xnotox/CEM3340/3D/cem3340v2_bottom.jpg

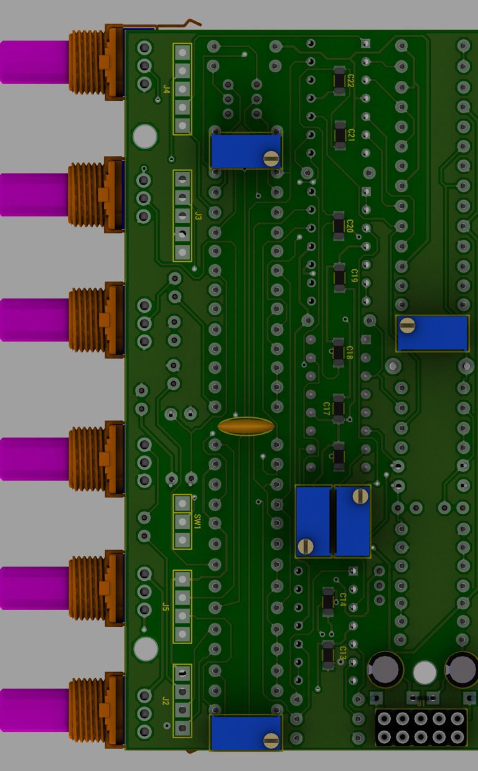
3D/cem3340v2_bottom.jpg
