xnotox/CEM3340/3D/cem3340v2_top.jpg

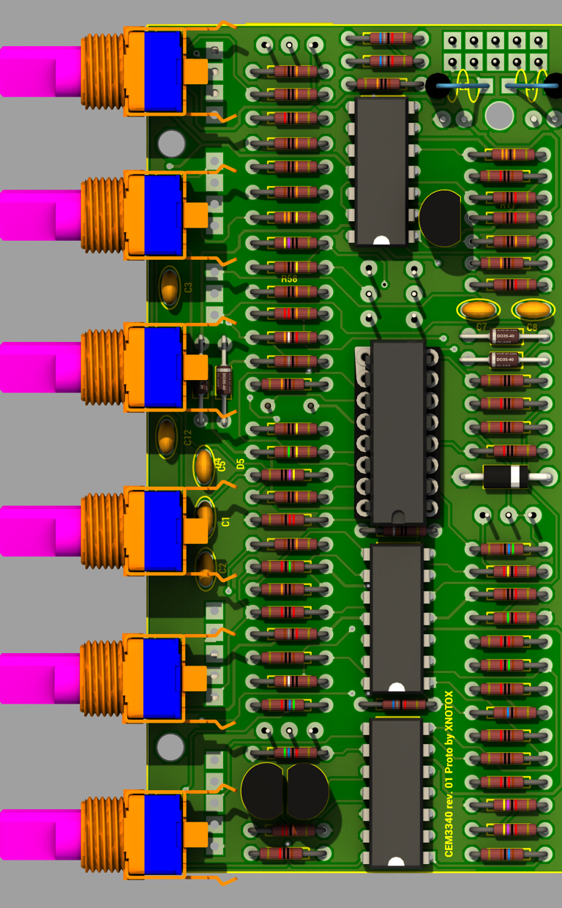
3D/cem3340v2_top.jpg
