xnotox/CEM3340/3D/cem3340v2_perspective.jpg

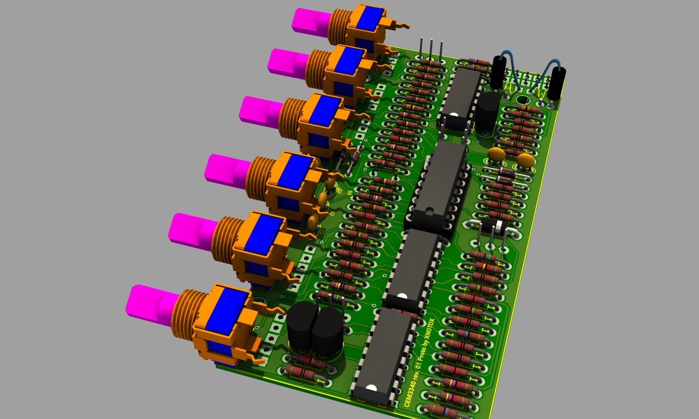
3D/cem3340v2_perspective.jpg
