xnotox/CEM3340/3D/cem3340v3_top.jpg

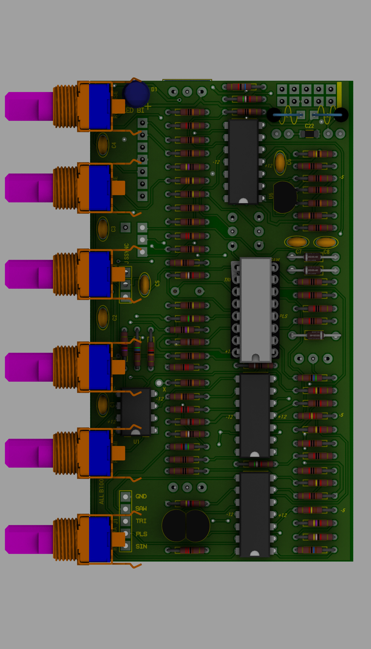
3D/cem3340v3_top.jpg
