xnotox/CEM3340/PANEL/cemop.dxf

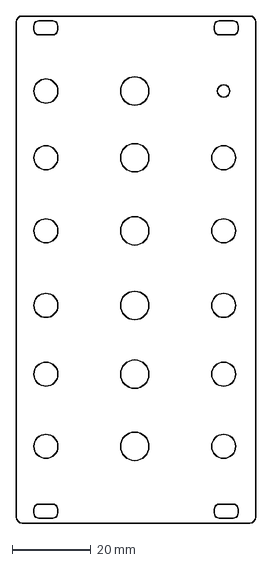
[picture p14: CAD file, 2016-11-08]
PANEL/cemop.dxf
60.6 x 128.4 mm
