xnotox/CEM3340/SCHEMATIC/OpenCEM3340_rev0.3_pulsealt.PDF

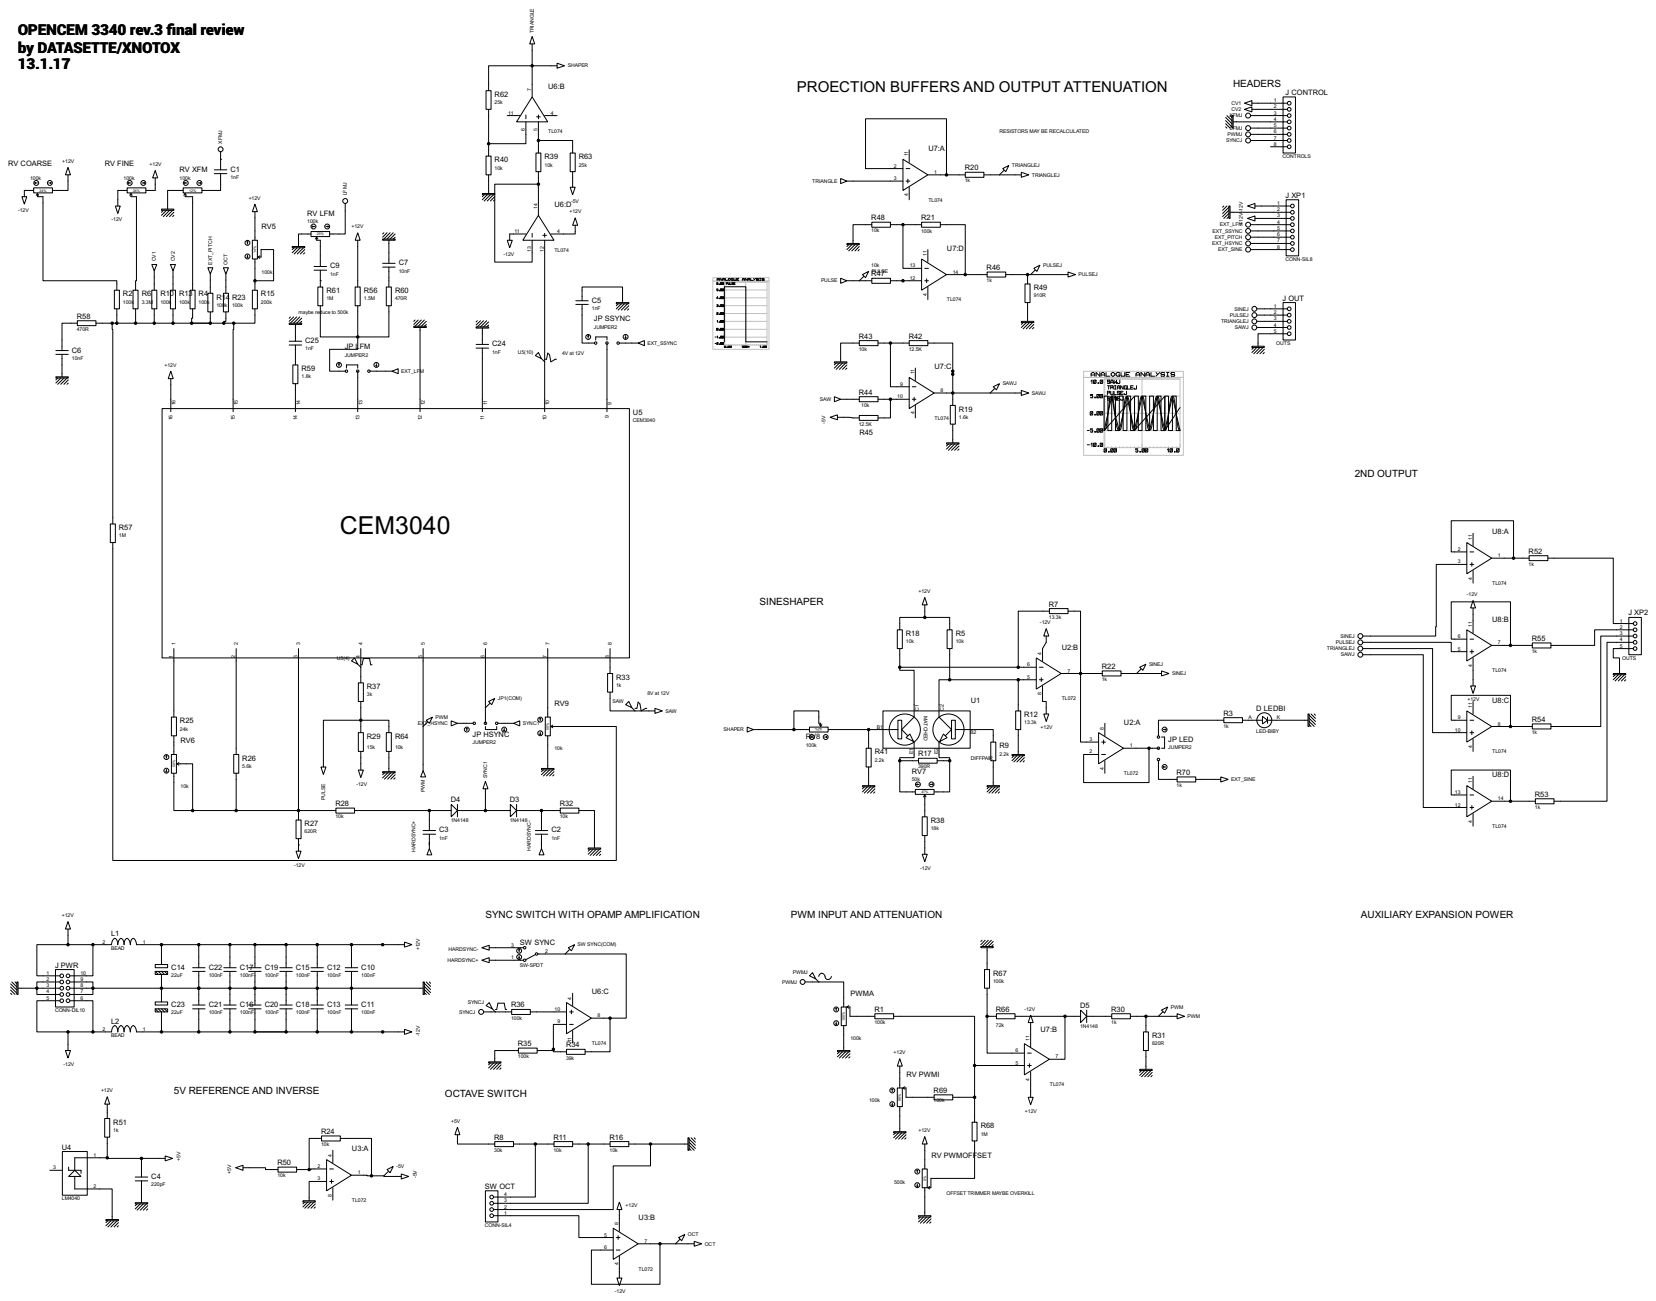
[picture p15: page 1]

OPENCEM 3340 rev.3 final review
by DATASETTE/XNOTOX

PROECTION BUFFERS AND OUTPUT ATTENUATION

RESISTORS MAY BE RECALCULATED

SAWJ TRIANGLEJ PULSEJ SINEJ

SYNC SWITCH WITH OPAMP AMPLIFICATION

PWM INPUT AND ATTENUATION

OFFSET TRIMMER MAYBE OVERKILL
