xnotox/CEM3340/SCHEMATIC/OpenCEM3340_rev0.22.PDF

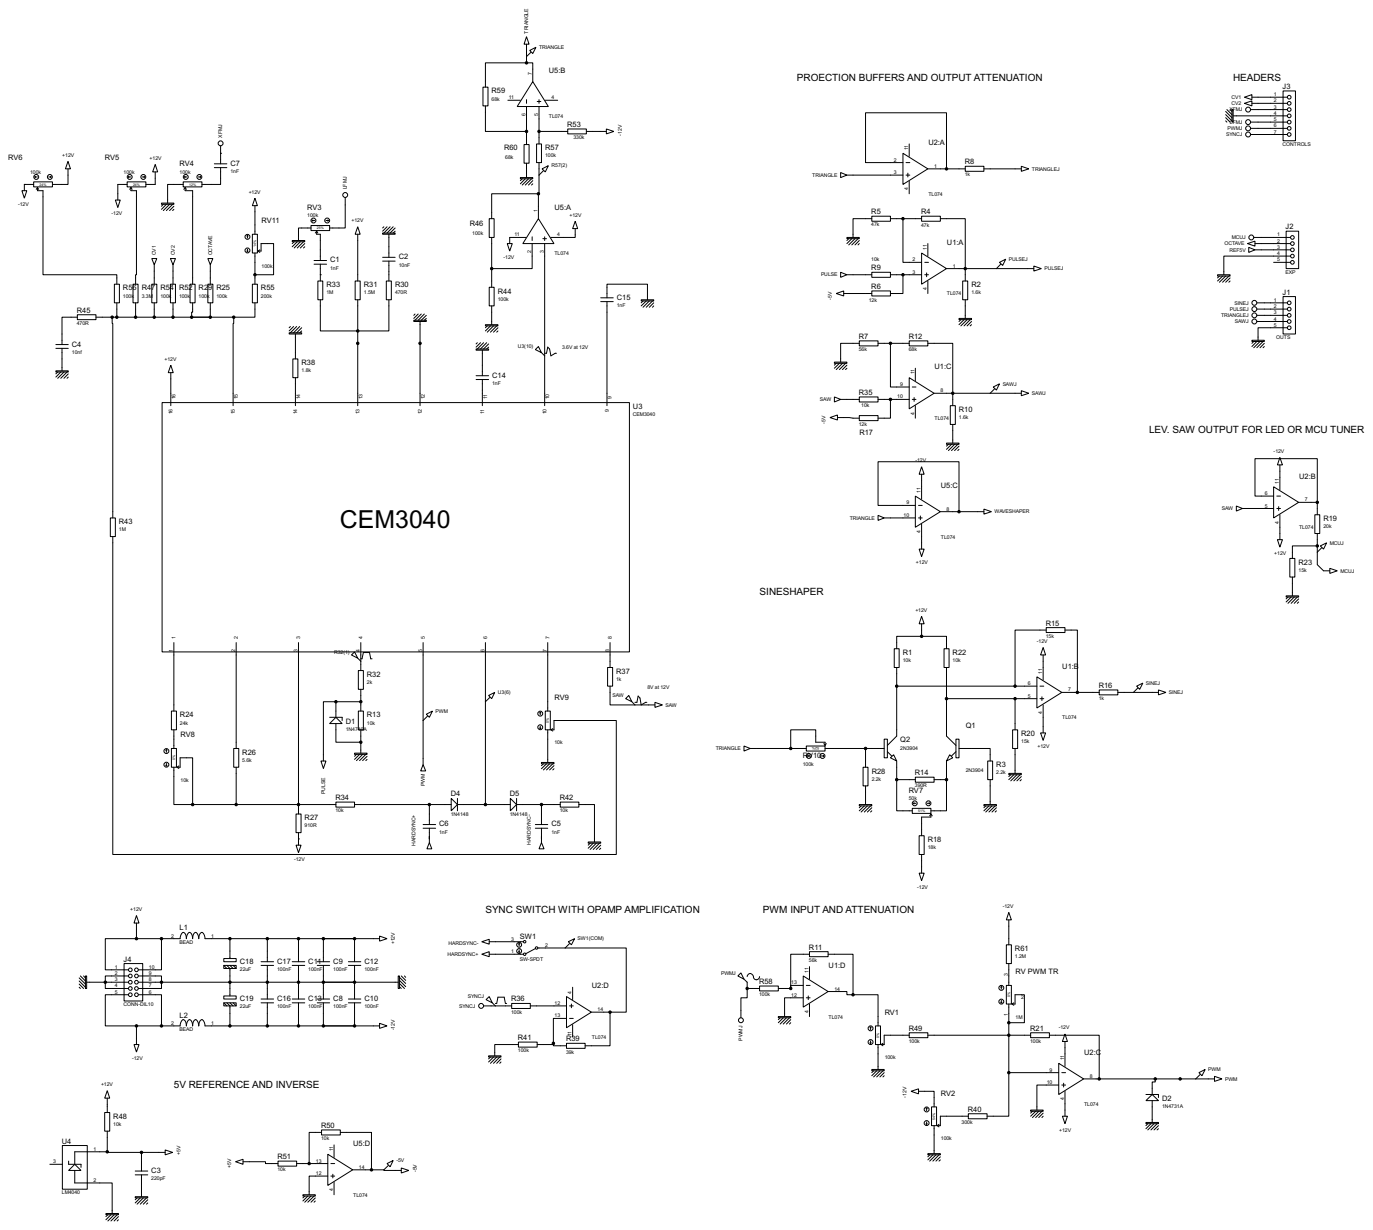
[picture p16: page 1]

PROECTION BUFFERS AND OUTPUT ATTENUATION

SAWJ TRIANGLEJ PULSEJ SINEJ

LEV. SAW OUTPUT FOR LED OR MCU TUNER

SYNC SWITCH WITH OPAMP AMPLIFICATION

PWM INPUT AND ATTENUATION
