xnotox/CEM3340/SCHEMATIC/tz.PDF

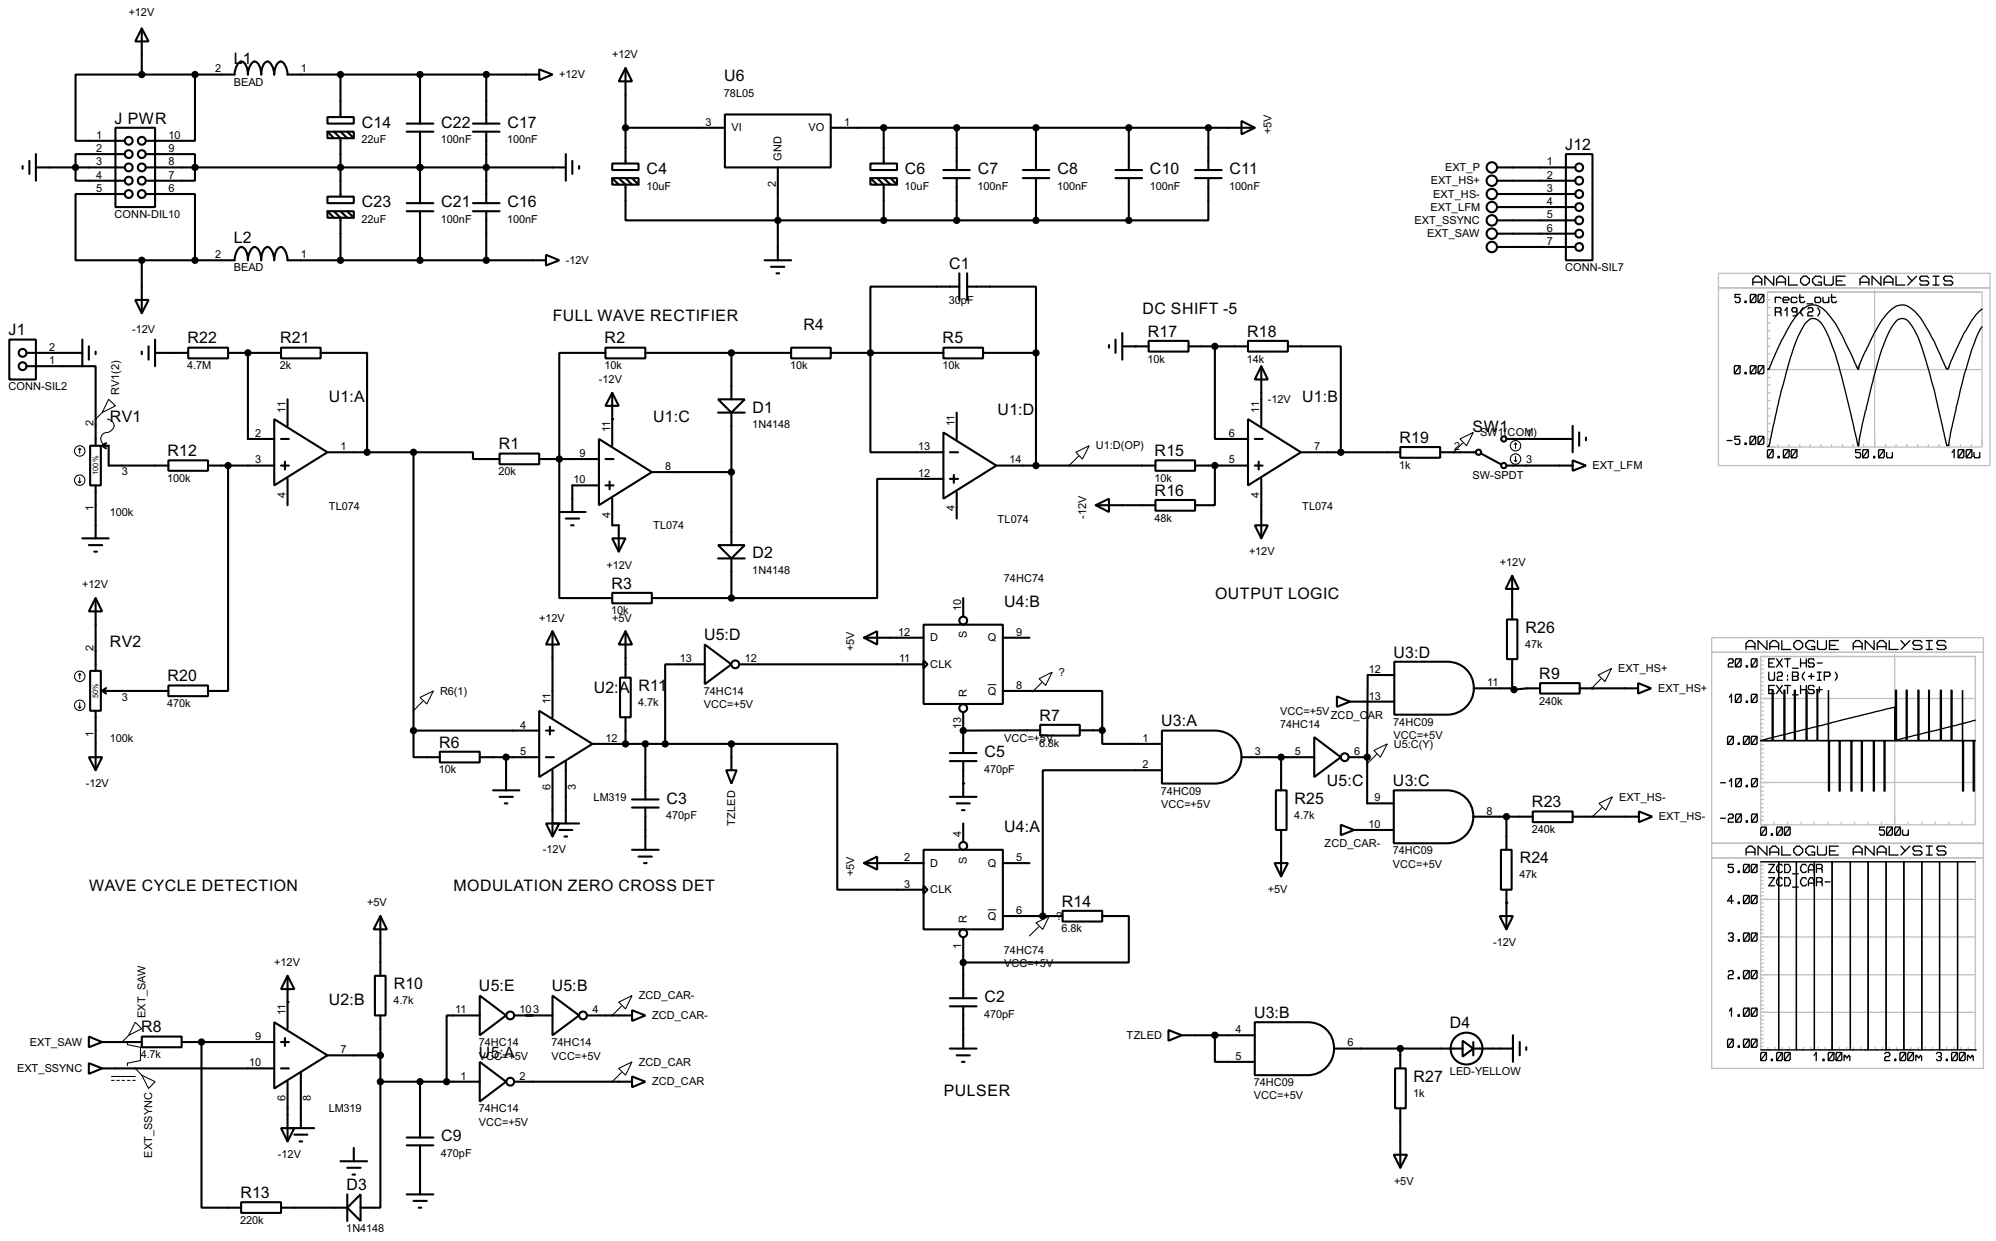
[picture p17: page 1]

MODULATION ZERO CROSS DET
