xnotox/CEM3340/THRUZERO/tzmax.PDF

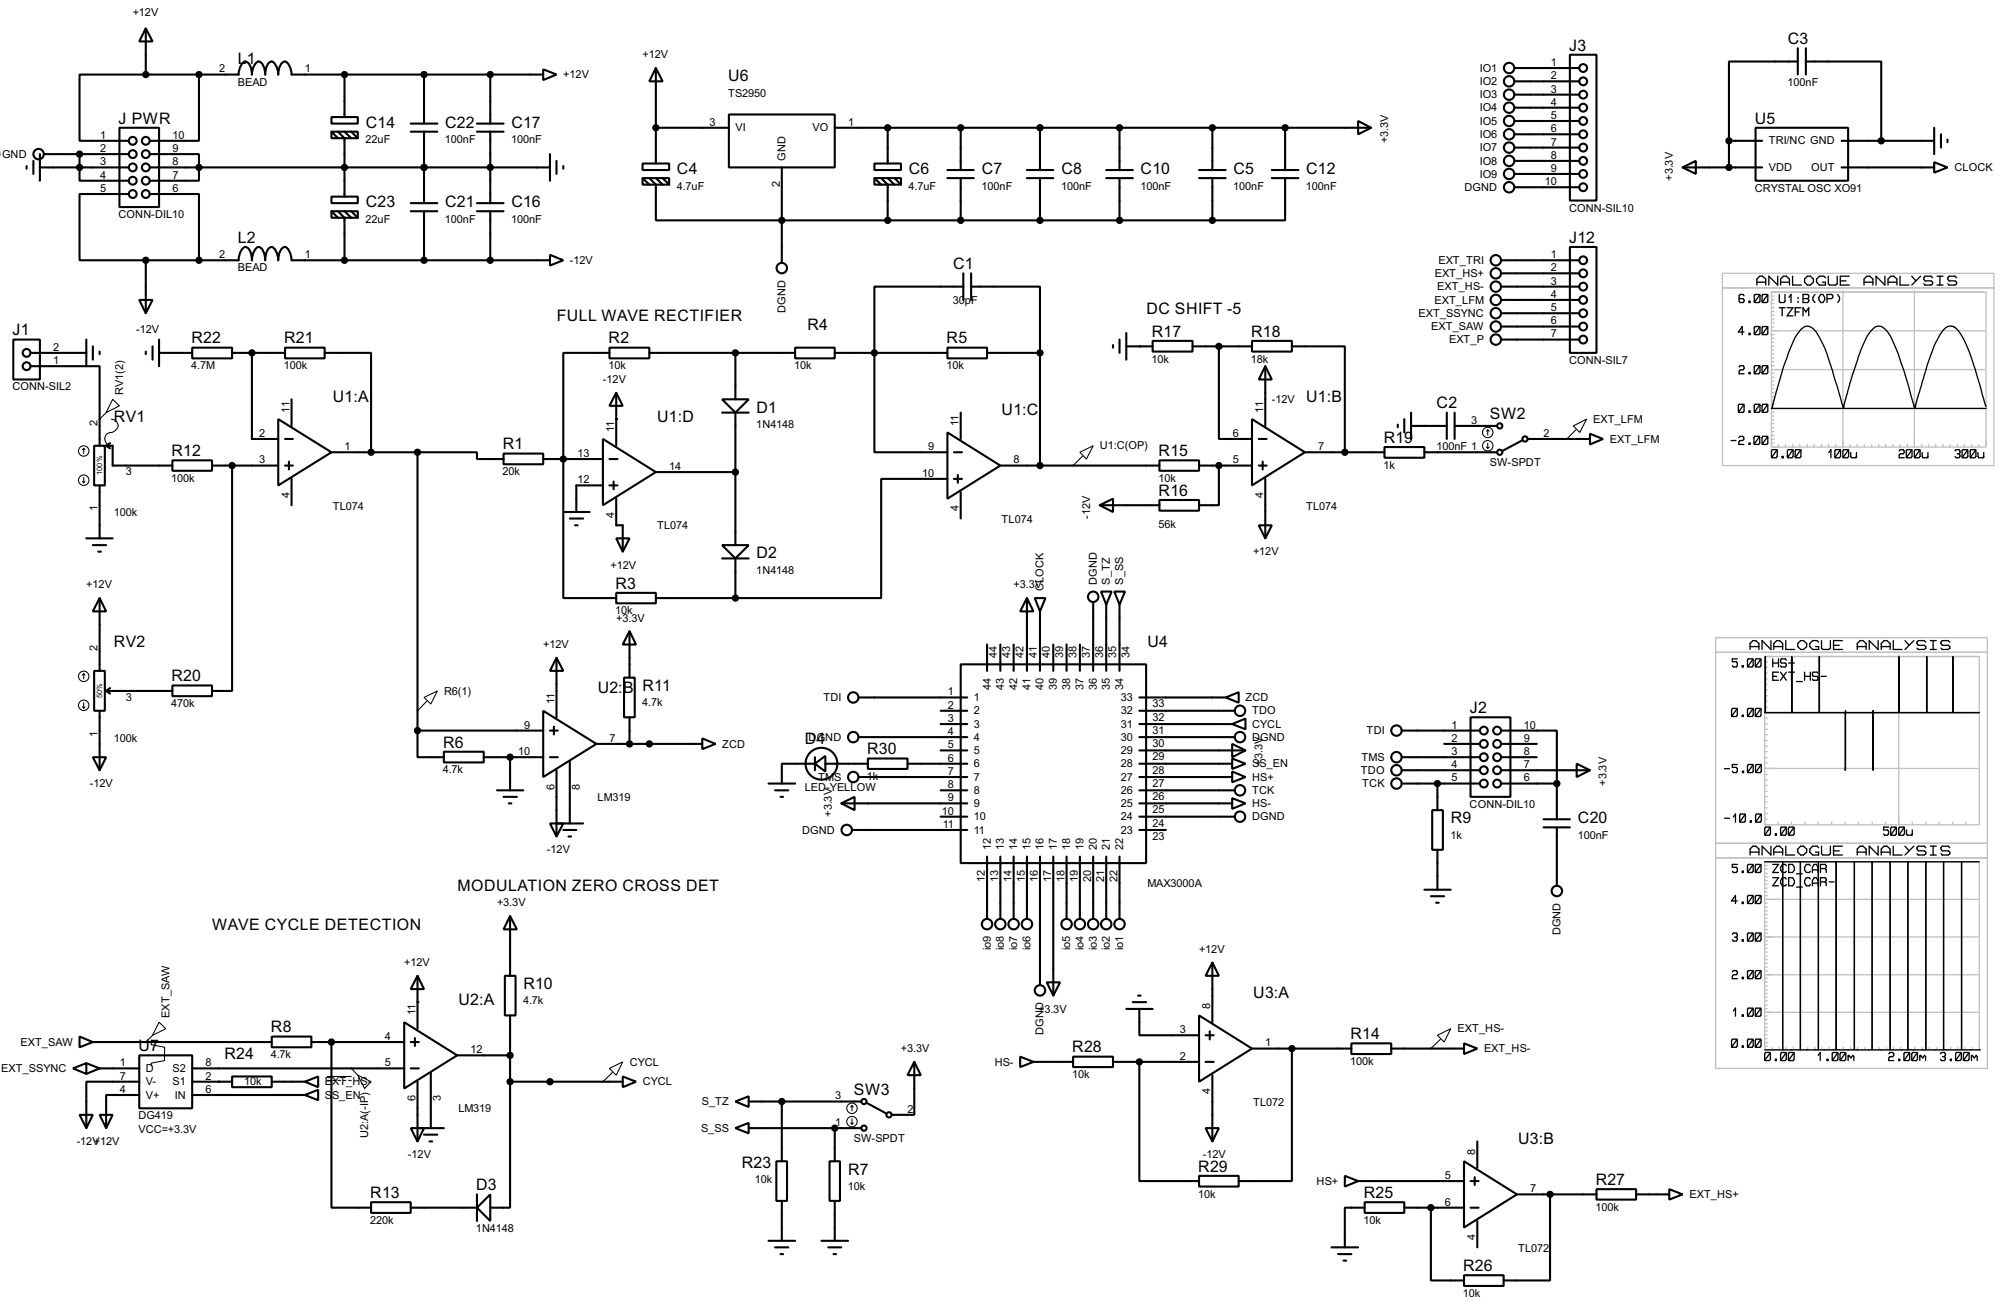
[picture p18: page 1]

MODULATION ZERO CROSS DET
