xnotox/CEM3340/(list of files, drawings)

Other design files:
PROTEUS/OpenCem_rev0.3.00.pdsprj
THRUZERO/tz.pdsprj
THRUZERO/tzmax.pdsprj
