xnotox/CEM3340/(commit log)

2016-11-17 Update Structure structur
    [OpenCem_rev0.2.01.pdsprj]
2017-01-08 v0.3 preview, still work in progress
    [OpenCem_rev0.2.01.pdsprj, OpenCem_rev0.3.00.pdsprj]
2017-01-11 still working but made huge improvements
    [OpenCem_rev0.3.00.pdsprj]
2017-01-13 up for final review and check
    [OpenCem_rev0.3.00.pdsprj]
2017-01-13 SCHEMATICS REVIEW VER. 03
2017-01-13 UPDATED CHANGELOG AND SCHEMATIC PDF
2017-01-13 the corrected schematic
2017-02-07 Revert "up for final review and check"
    This reverts commit 09a07996b608d7fc8fff4221a2bdd703bd0b62ad.
    [OpenCem_rev0.3.00.pdsprj]
2017-02-10 Still work in progress!
    [OpenCem_rev0.3.00.pdsprj]
2017-02-10 STILL WORK IN PROGRESS
    [tz.pdsprj]
2017-02-11 FINAL REVIEW AND WIRE CHECK
    [tz.pdsprj]
2017-02-11 ADDED THRU ZERO SCHEMATIC
2017-02-21 Finally of to the fab house - if health gets better i plan to assemble and test as soon as it arrives - hopefully 14 days
    [OpenCem_rev0.3.00.pdsprj, tzmax.pdsprj]
2017-03-02 preliminary DOK and Panel gerbers added
    [tzmax.pdsprj]
